KazanNinja/MM36-Dash/MM36-Dash/Endurance_24_Trace.png

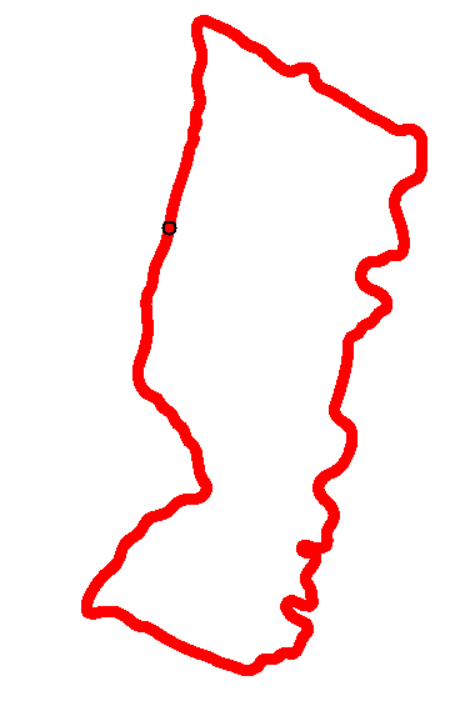
MM36-Dash/Endurance_24_Trace.png
