KazanNinja/MM36-Dash/MM36-Dash/rick roll.jpg

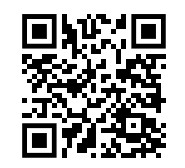
MM36-Dash/rick roll.jpg
