KazanNinja/MM36-Dash/MM36-Dash/MM36-Dash.SLDPRT

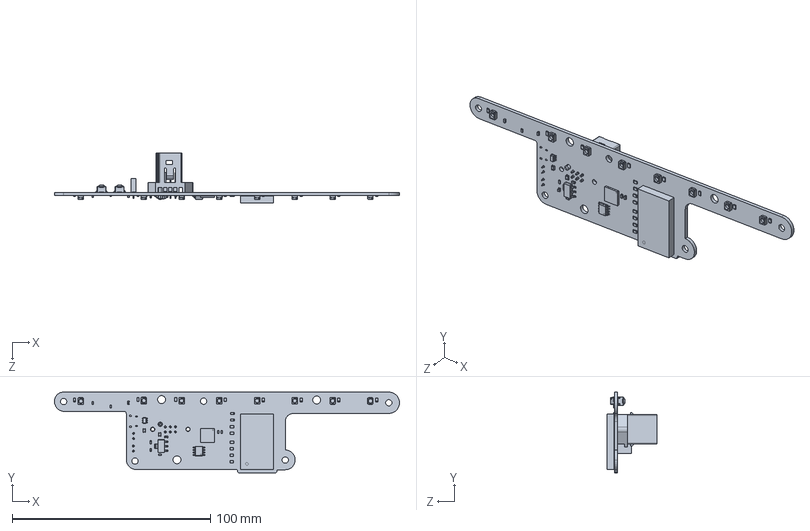
[picture p3: CAD file, 2025-02-18]
MM36-Dash/MM36-Dash.SLDPRT
174.0 x 40.8 x 25.5 mm
