KazanNinja/MM36-Dash/MM36-Dash/MM36-Dash.kicad_pcb

## KiCad design MM36-Dash/MM36-Dash.kicad_pcb (2025-02-18)

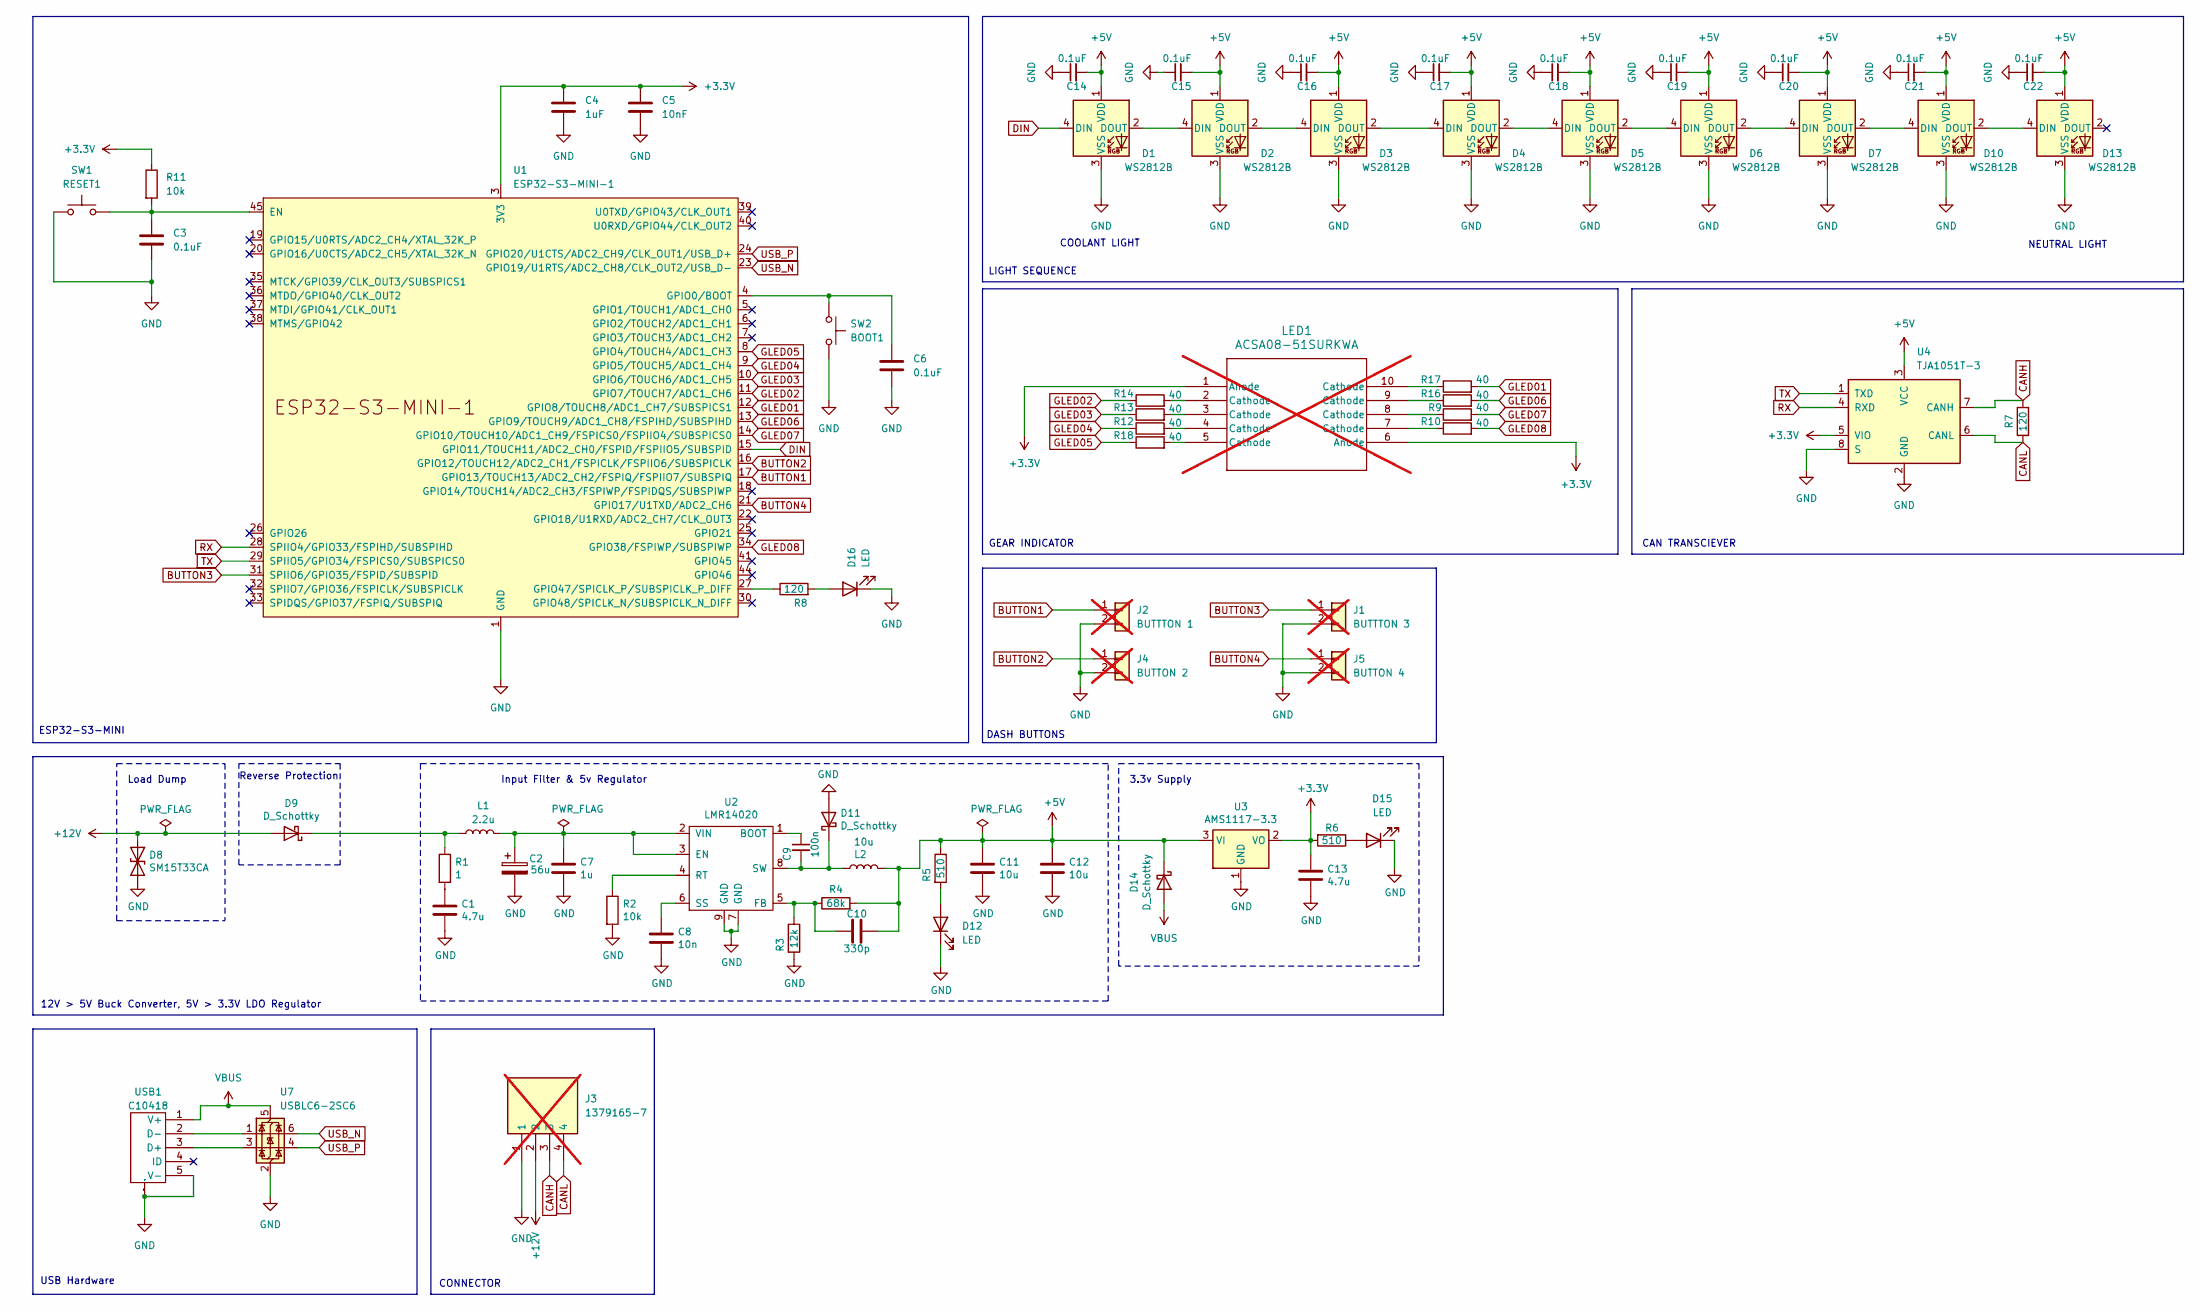
[picture p4: schematic MM36-Dash.kicad_sch]

Parts:
C1, C13: 4.7u; C_0603_1608Metric; LCSC C19666
C2: 56u; CP_Radial_D8.0mm_P2.50mm; LCSC C106629
C3, C6, C14, C15, C16, C17, C18, C19, C20, C21, C22: 0.1uF; C_0603_1608Metric; LCSC C14663
C4: 1uF; C_0603_1608Metric; LCSC C15849
C5: 10nF; C_0603_1608Metric; LCSC C57112
C7: 1u; C_0603_1608Metric; LCSC C15849
C8: 10n; C_0603_1608Metric; LCSC C57112
C9: 100n; C_0603_1608Metric; LCSC C14663
C10: 330p; C_0603_1608Metric; LCSC C1664
C11, C12: 10u; C_1206_3216Metric; LCSC C13585
D1, D2, D3, D4, D5, D6, D7, D10, D13: WS2812B; LED_WS2812B_PLCC4_5.0x5.0mm_P3.2mm; LCSC C2761795
D8: SM15T33CA; D_SMC; LCSC C151281
D9, D11, D14: D_Schottky; D_SMA; LCSC C8678
D12, D15, D16: LED; LED_0805_2012Metric; JLCPCB C2297
J1: BUTTTON 3; PinSocket_1x02_P1.27mm_Vertical; not fitted
J2: BUTTTON 1; PinSocket_1x02_P1.27mm_Vertical; not fitted
J3: 1379165-7; 13791657; Manufacturer_Part_Number 1379165-7; Mouser Part Number 571-1379165-7; not fitted
J4: BUTTON 2; PinSocket_1x02_P1.27mm_Vertical; not fitted
J5: BUTTON 4; PinSocket_1x02_P1.27mm_Vertical; not fitted
L1: 2.2u; L_1210_3225Metric; LCSC C286757
L2: 10u; L_Sunlord_MWSA0503S; LCSC C408412
LED1: ACSA08-51SURKWA; LED10_ACSA08-51SURKWA_KNB; not fitted
R1: 1; R_0603_1608Metric; LCSC C22936
R2, R11: 10k; R_0603_1608Metric; LCSC C25804
R3: 12k; R_0603_1608Metric; LCSC C22790
R4: 68k; R_0603_1608Metric; LCSC C23231
R5, R6: 510; R_0603_1608Metric; LCSC C23193
R7, R8: 120; R_0603_1608Metric; LCSC C22787
R9, R10, R12, R13, R14, R16, R17, R18: 40; R_0805_2012Metric; LCSC C5355206
SW1: RESET1; SW_SPST_TL3342; LCSC C318884
SW2: BOOT1; SW_SPST_TL3342; LCSC C318884
U1: ESP32-S3-MINI-1; ESP32-S3-MINI-1U; LCSC C2980299
U2: LMR14020; SOIC-8-1EP_3.9x4.9mm_P1.27mm_EP2.29x3mm; LCSC C187824
U3: AMS1117-3.3; SOT-223-3_TabPin2; LCSC C6186
U4: TJA1051T-3; SOIC-8_3.9x4.9mm_P1.27mm; LCSC C5342108
U7: USBLC6-2SC6; SOT-23-6; LCSC C2827654
USB1: C10418; MICRO-USB-SMD_5P-P0.65-H-F_C10418; Manufacturer Part 920-E52A2021S10100; LCSC Part Name Micro-B 母

Connections:
+3.3V: C4.1, C5.1, C13.1, LED1.1 (Anode), LED1.6 (Anode), R6.2, R11.1, U1.3 (3V3), U3.2 (VO), U4.5 (VIO)
+5V: C10.1, C11.1, C12.1, C14.2, C15.2, C16.2, C17.2, C18.2, C19.2, C20.2, C21.2, C22.2, D1.1 (VDD), D2.1 (VDD), D3.1 (VDD), D4.1 (VDD), D5.1 (VDD), D6.1 (VDD), D7.1 (VDD), D10.1 (VDD), D13.1 (VDD), D14.1 (K), L2.2, R4.2, R5.1, U3.3 (VI), U4.3 (VCC)
+12V: D8.1 (A1), D9.2 (A), J3.2
BUTTON1: J2.1, U1.17 (GPIO13/TOUCH13/ADC2_CH2/FSPIQ/FSPIIO7/S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)
BUTTON2: J4.1, U1.16 (GPIO12/TOUCH12/ADC2_CH1/FSPICLK/FSPIIO6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)
BUTTON3: J1.1, U1.31 (SPIIO6/GPIO35/FSPID/SUBSPID)
BUTTON4: J5.1, U1.21 (GPIO17/U1TXD/ADC2_CH6)
CANH: J3.3, R7.2, U4.7 (CANH)
CANL: J3.4, R7.1, U4.6 (CANL)
DIN: D1.4 (DIN), U1.15 (GPIO11/TOUCH11/ADC2_CH0/FSPID/FSPIIO5/S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)
GLED01: R17.2, U1.12 (GPIO8/TOUCH8/ADC1_CH7/SUBSPICS1)
GLED02: R14.1, U1.11 (GPIO7/TOUCH7/ADC1_CH6)
GLED03: R13.1, U1.10 (GPIO6/TOUCH6/ADC1_CH5)
GLED04: R12.1, U1.9 (GPIO5/TOUCH5/ADC1_CH4)
GLED05: R18.1, U1.8 (GPIO4/TOUCH4/ADC1_CH3)
GLED06: R16.2, U1.13 (GPIO9/TOUCH9/ADC1_CH8/FSPIHD/SUBSPIHD)
GLED07: R9.2, U1.14 (GPIO10/TOUCH10/ADC1_CH9/FSPICS0/FSPIIO4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)
GLED08: R10.2, U1.34 (GPIO38/FSPIWP/SUBSPIWP)
GND: C1.2, C2.2, C3.2, C4.2, C5.2, C6.2, C7.2, C8.2, C11.2, C12.2, C13.2, C14.1, C15.1, C16.1, C17.1, C18.1, C19.1, C20.1, C21.1, C22.1, D1.3 (VSS), D2.3 (VSS), D3.3 (VSS), D4.3 (VSS), D5.3 (VSS), D6.3 (VSS), D7.3 (VSS), D8.2 (A2), D10.3 (VSS), D11.2 (A), D12.1 (K), D13.3 (VSS), D15.1 (K), D16.1 (K), J1.2, J2.2, J3.1, J4.2, J5.2, R2.2, R3.2, SW1.2, SW2.2, U1.1 (GND), U1.2 (GND), U1.42 (GND), U1.43 (GND), U1.46 (GND), U1.47 (GND), U1.48 (GND), U1.49 (GND), U1.50 (GND), U1.51 (GND), U1.52 (GND), U1.53 (GND), U1.54 (GND), U1.55 (GND), U1.56 (GND), U1.57 (GND), U1.58 (GND), U1.59 (GND), U1.60 (GND), U1.61 (GND), U1.62 (GND), U1.63 (GND), U1.64 (GND), U1.65 (GND), U2.7 (GND), U2.9 (GND), U3.1 (GND), U4.2 (GND), U4.8 (S), U7.2 (GND), USB1.5 (V-), USB1.SH0 (MTN), USB1.SH1 (1), USB1.SH2 (2), USB1.SH3 (3); also elsewhere on the board
unnamed: C1.1, R1.2
unnamed: D1.2 (DOUT), D2.4 (DIN)
unnamed: D2.2 (DOUT), D3.4 (DIN)
unnamed: D3.2 (DOUT), D4.4 (DIN)
unnamed: D4.2 (DOUT), D5.4 (DIN)
unnamed: D5.2 (DOUT), D6.4 (DIN)
unnamed: D6.2 (DOUT), D7.4 (DIN)
unnamed: D9.1 (K), L1.1, R1.1
unnamed: D7.2 (DOUT), D10.4 (DIN)
unnamed: D10.2 (DOUT), D13.4 (DIN)
unnamed: C9.2, D11.1 (K), L2.1, U2.8 (SW)
unnamed: D12.2 (A), R5.2
unnamed: D15.2 (A), R6.1
unnamed: D16.2 (A), R8.2
unnamed: LED1.2 (Cathode), R14.2
unnamed: LED1.3 (Cathode), R13.2
unnamed: LED1.4 (Cathode), R12.2
unnamed: LED1.5 (Cathode), R18.2
unnamed: LED1.7 (Cathode), R10.1
unnamed: LED1.8 (Cathode), R9.1
unnamed: LED1.9 (Cathode), R16.1
unnamed: LED1.10 (Cathode), R17.1
unnamed: C3.1, R11.2, SW1.1, U1.45 (EN)
unnamed: C6.1, SW2.1, U1.4 (GPIO0/BOOT)
unnamed: R8.1, U1.27 (GPIO47/SPICLK_P/SUBSPICLK_P_DIFF)
unnamed: C9.1, U2.1 (BOOT)
unnamed: C2.1, C7.1, L1.2, U2.2 (VIN), U2.3 (EN)
unnamed: C10.2, R3.1, R4.1, U2.5 (FB)
unnamed: R2.1, U2.4 (RT)
unnamed: C8.1, U2.6 (SS)
unnamed: U7.3 (I/O2), USB1.3 (D+)
unnamed: U7.1 (I/O1), USB1.2 (D-)
RX: U1.28 (SPIIO4/GPIO33/FSPIHD/SUBSPIHD), U4.4 (RXD)
TX: U1.29 (SPIIO5/GPIO34/FSPICS0/SUBSPICS0), U4.1 (TXD)
USB_N: U1.23 (GPIO19/U1RTS/ADC2_CH8/CLK_OUT2/USB_D-), U7.6 (I/O1)
USB_P: U1.24 (GPIO20/U1CTS/ADC2_CH9/CLK_OUT1/USB_D+), U7.4 (I/O2)
VBUS: D14.2 (A), U7.5 (VBUS), USB1.1 (V+)

Notes on the sheet:
Input Filter & 5v Regulator
DASH BUTTONS
ESP32-S3-MINI
NEUTRAL LIGHT
GEAR INDICATOR
Reverse Protection
CONNECTOR
COOLANT LIGHT
LIGHT SEQUENCE
USB Hardware
CAN TRANSCIEVER
Load Dump
12V > 5V Buck Converter, 5V > 3.3V LDO Regulator
3.3v Supply

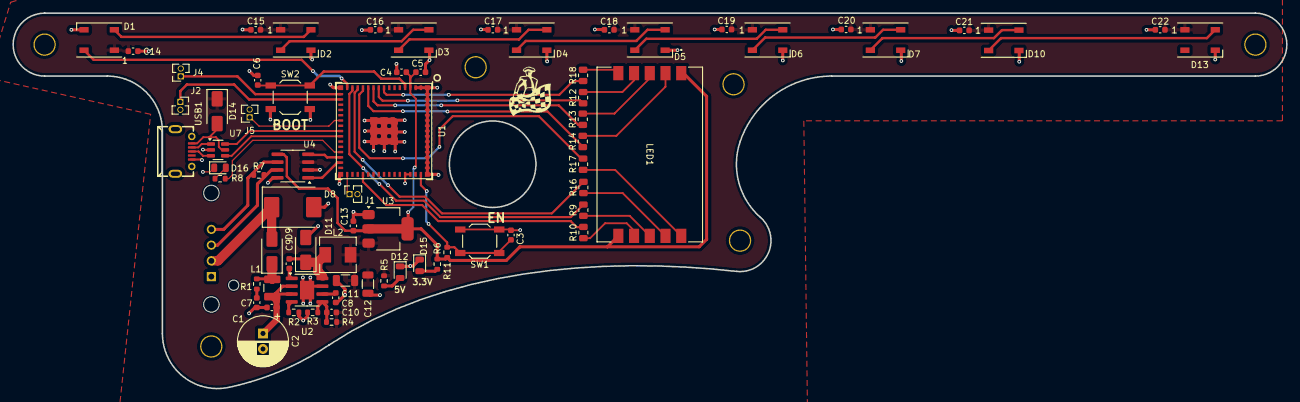
[picture p5: board MM36-Dash.kicad_pcb from above]

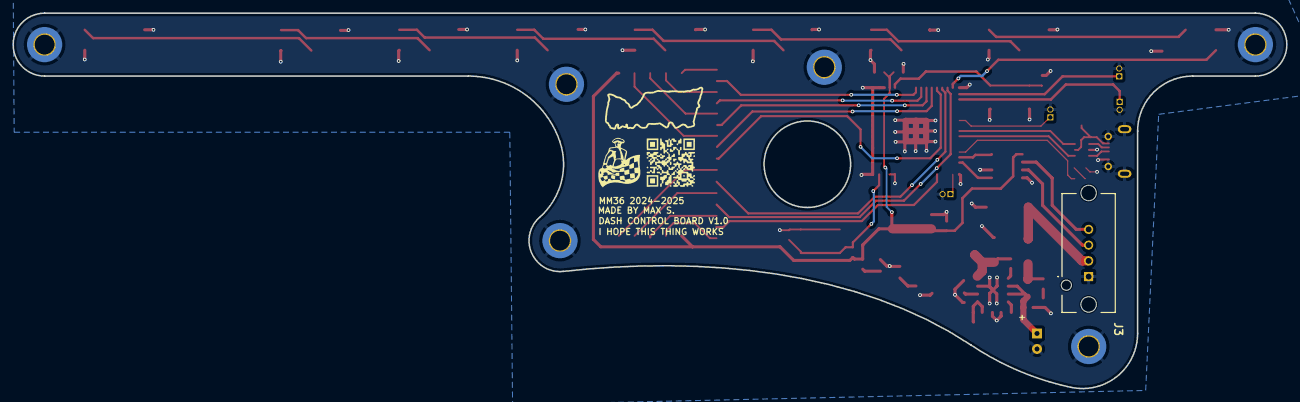
[picture p6: board MM36-Dash.kicad_pcb from below]

Board: 2 copper layers, 205.7 x 60.6 mm, 73 parts (3 on the bottom side), 56 nets.

Other parts of the board:
H1, H1#2: MountingHole_3.2mm_M3_ISO7380_Pad_TopOnly

Their connections:
GND: H1.1, H1#2.1; also elsewhere on the board
