KazanNinja/MM36-Dash/(commit log)

2025-02-16 Gear Positions
    Added gear position things for the segment display
2025-02-16 Cleaned up, more gear position logic
    added timer for gear 14 error code thing
    [MM36-Dash.ino]
2025-02-16 Status LED Stuff
    Made some changes to status LED
2025-02-16 More status LED
    idk im just messing with stuff now
2025-02-17 Gear Indicator
    Accidentally flipped 7-segment display in PCB layout, corrected pinouts on ESP for that. Other RTOS priority changes. vTaskDelay changes. 7-segment also pulls HIGH on segments not needed for corresponding gear cause they would float or whatever.
    [MM36-Dash.ino]
2025-02-18 Added KiCAD Files
    [BOM-MM36-Dash.csv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]
2025-02-20 Latest Revision
    Corrected RPM thresholds, removed print statement
    [MM36-Dash.ino]
2025-03-11 RTOS
    Changed some RTOS stuff so the main tasks run at fixed intervals and not just ass blasting all the time
    [MM36-Dash.ino]
